hannahhhhhhhhhhhhhhh/custom-keyboard/images/pcb-3d.png

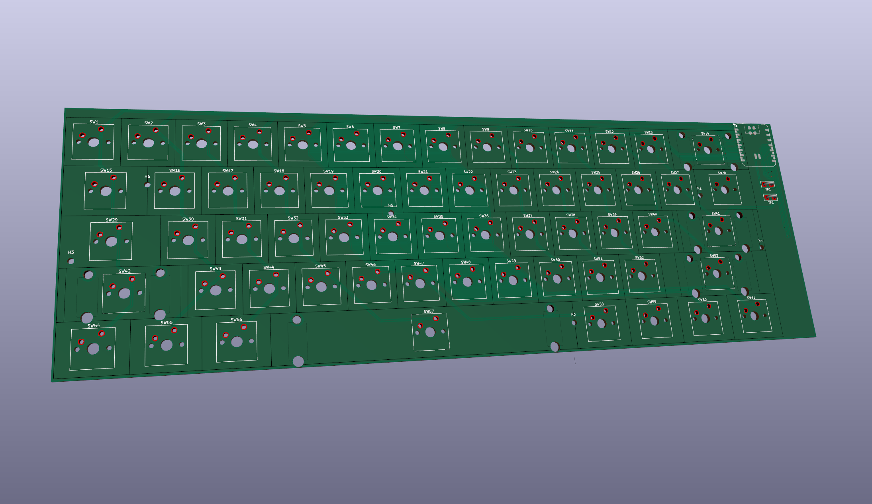
images/pcb-3d.png
