hannahhhhhhhhhhhhhhh/custom-keyboard/images/pcb.png

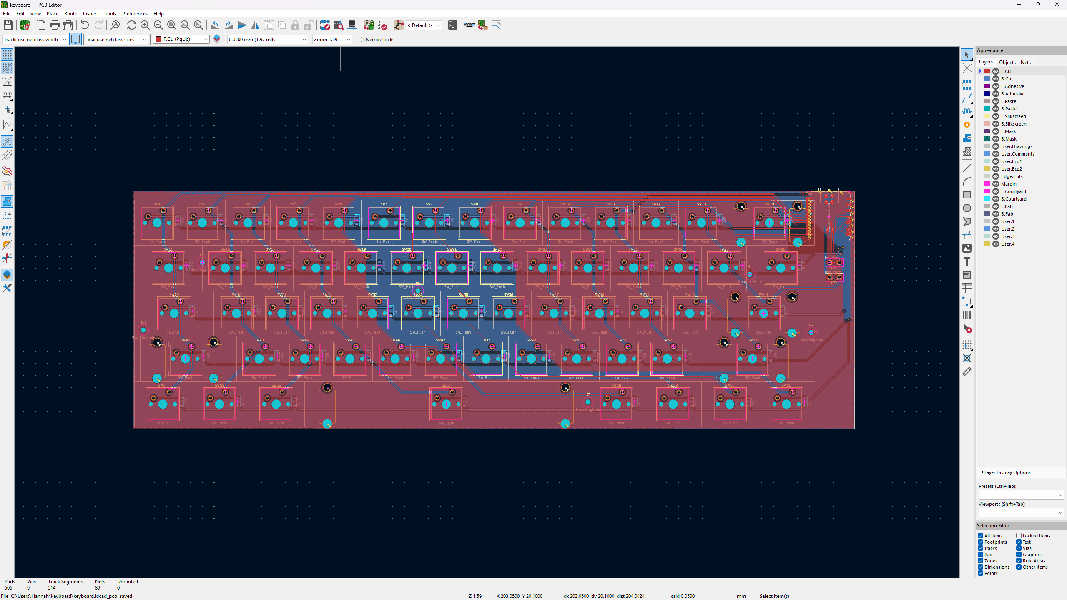
images/pcb.png
