hannahhhhhhhhhhhhhhh/custom-keyboard/images/schematic.png

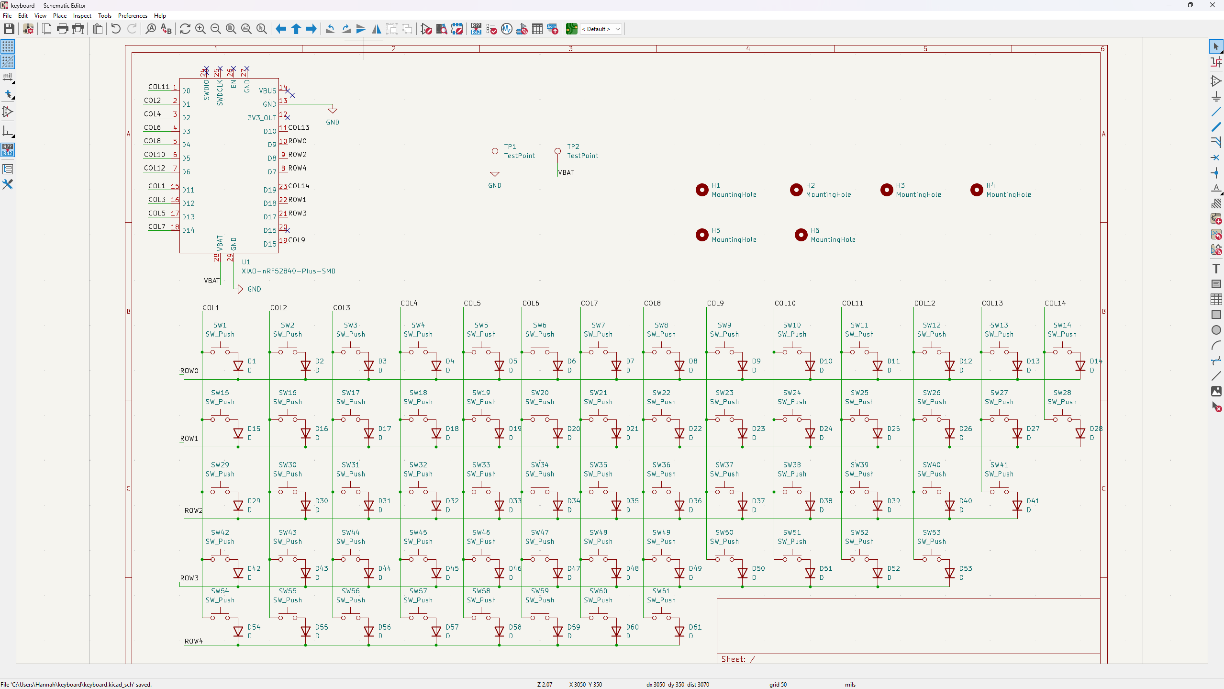
images/schematic.png
