hannahhhhhhhhhhhhhhh/custom-keyboard/BOM.csv

Item | Qty | Supplier | Cost/item | Total Cost | link
PCB | 1 | JLPCB | $34.12 | $34.12 | https://cart.jlcpcb.com/quote?stencilLayer=2&stencilWidth=100&stencilLength=100&stencilCounts=5&plateType=1
Seeed Studio XIAO nRF52840 Plus | 1 | Seeed studio | $15.00 | $15.00 | https://ca.robotshop.com/checkouts/cn/hWNHkaPCI6t1JQWKFscHSgSX/en-ca
ECSiNG 7Pcs 2U Stabilizers & 1Pcs 6.25U Stabilizer Replacement Mechanical Keyboard Stabilizers Plate Mount Stabilizers K | 1 | ECSiNG | $13.19 | $13.19 | https://www.amazon.ca/ECSiNG-Stabilizers-Stabilizer-Replacement-Accessories/dp/B0FGHP1QQN
Estimated total shipping | 1 |  |  | $40.47
