hannahhhhhhhhhhhhhhh/custom-keyboard/JOURNAL.md

# mechanical keyboard: devlog

<!-- Generated by Half Life from project b6safdi3w72jnbnciox2tt2c. Edits here are overwritten on the next sync. -->
<!-- Generated: 2026-11-07T22:35:55.124Z -->

> [!NOTE]
> This devlog is mirrored from [Half Life](https://halflife.hackclub.com) ([open the project](https://halflife.hackclub.com/projects/b6safdi3w72jnbnciox2tt2c)). Editing it here will not change the platform's copy, and the next sync overwrites this file.

> This week I've been sick at home but I get a lot of time each day to work on my project! I want to make my first mechanical keyboard :D I also learned rmk for the firmware of this project and learned about keyboard matrixes, downloaded a bunch of footprint libraries and it was fun. Initially I wanted to just make a standard 60% keyboard so I can buy a case, but ended up just making a custom one.  Sorry I couldn't add the STEP files to the 3D viewer to make it look better. my computer keeps crashing when I  go to the footprint editor trying to give it a model

| Week | Tier | Hours logged | Entries |
| --- | --- | --- | --- |
| Week 5 | Tier 3 | 28.5h | 12 |

## Contents

1. [2026-11-04: ](#2026-11-04-imagehttpshalflifehackclub-assetscomsessionsyitt1)
2. [2026-11-04:  em I just did the battery thing and realis](#2026-11-04-imagehttpshalflifehackclub-assetscomsessionsyitt1)
3. [2026-11-05: so! i forgor keys have different sizes. and that stabalizers are a thing. so time to add them:](#2026-11-05-so-i-forgor-keys-have-different-sizes-and-that-st)
4. [2026-11-05: alr added the battery thingy after removing it.](#2026-11-05-alr-added-the-battery-thingy-after-removing-it)
5. [2026-11-05: alr late night session:](#2026-11-05-alr-late-night-session)
6. [2026-11-06: oh boy.... firmware time](#2026-11-06-oh-boy-firmware-time)
7. [2026-11-06: honestly, these 3 hours went mostly in troubleshooting firmware, rewriting firmware, rewriting keyboard.toml,  rewriting keyboard.toml, rewriting keyboard.toml, and discovering that it was not my prob](#2026-11-06-honestly-these-3-hours-went-mostly-in-troubleshoo)
8. [2026-11-06: ](#2026-11-06-imagehttpshalflifehackclub-assetscomsessionsyitt1)
9. [2026-11-06: getting the parts prices. kinda expensive](#2026-11-06-imagehttpshalflifehackclub-assetscomsessionsyitt1)
10. [2026-11-06: ive been working on this like the whole day ![image](https://halflife.hackclub-assets.com/sessions/YITT1BpIhaUfu2wESuCR2Vtd1HPsflo7/75fb0d03e48f4bb6bfa1e31089601be968123c0c54cd4f1a398dd703231ae498.png](#2026-11-06-ive-been-working-on-this-like-the-whole-day-image)
11. [2026-11-07: doing some housekeeping tasks this session: fixed all the errors and stuff on kicad, pcb officially complete! AND THE FIRMWARE WORKS!!!!!!!!!!!!!!!!!!!!!](#2026-11-07-doing-some-housekeeping-tasks-this-session-fixed-)
12. [2026-11-07: IM DONE!!! YAYY!!!](#2026-11-07-im-done-yayy)

## Design

### 2026-11-04: 

**4h**


to start my project I did some research learning about details of full keyboards because even though I've done projects with keys.. this has more keys sooo I need more help

(aggressively learning about matrix and restarting my work like 5 times)

then i settled with this keyboard layout...
oops just realized wrong microcontroller: there we go


YIPPEE



### 2026-11-04:  em I just did the battery thing and realis

**1h**

 em I just did the battery thing and realised I have no pins left oops. Also assigned all the footprints and spent a while on figuring out why I can't find a footprint for my microcontroller but eventually figured it out



### 2026-11-05: so! i forgor keys have different sizes. and that stabalizers are a thing. so time to add them:

**4h**

so! i forgor keys have different sizes. and that stabalizers are a thing. so time to add them:

 thats better

 i placed the pcb using the keyboad builder exported json because i wanted to make it fit in an typical 60% aluminum case and not a printed one

 um. also forgot microcontrollers exist and it doesnt fit. I'll need a custom case anyways. there goes 1 hour of rearranging everything

 also slight restart of the schematic bc i wired it wrong first time and i wanted it to be neater

### 2026-11-05: alr added the battery thingy after removing it.

**2h**

alr added the battery thingy after removing it.


..........so 30 minutes later im proud to announce: I REMOVED IT AGAIN YAYAYYAYAY!!!!

 :sobbing:
aaand time to change the firmware thingy too then rewire pcb again

### 2026-11-05: alr late night session:

**1h**

alr late night session:

 fixing stabilizer thingy i have no clue how it works so went through a ton of googling.

 idk apparently it was kicad thing and i can ignore all the stabilizer overlap errors so i just ignored it

### 2026-11-06: oh boy.... firmware time

**4h**

oh boy.... firmware time
so, hour one went to learning rmk from scratch :fear:


and I chose cloud compilation.
yes, that went another one hour.


it was then I realised, I may have to reread the entire guide and then it's time to edit the toml thingy.

and I found another guide telling me how to do the json file because ive been using arduino as my firmware for toher projects. this is lowkey taking so much more time than the actual pcb.



### 2026-11-06: honestly, these 3 hours went mostly in troubleshooting firmware, rewriting firmware, rewriting keyboard.toml,  rewriting keyboard.toml, rewriting keyboard.toml, and discovering that it was not my prob

**3h**

honestly, these 3 hours went mostly in troubleshooting firmware, rewriting firmware, rewriting keyboard.toml,  rewriting keyboard.toml, rewriting keyboard.toml, and discovering that it was not my problem. local compilation time!!! theres a TON of downloading and my wifi was not helping.
lowkey spent 30+ minutes downloading everything
and i had some trouble with windows defender not allowing me to download anything cuz its a new device and didn't set everything up yet.

 genuinely praying to my computer as the things ran

 i mean i dont really have a lot of photos other than my cmd window but,

heres the things i downloaded : rust, clang, c++ thing, visual studio, then all the tools

### 2026-11-06: 

**2h**


so basically I accidentally deleted this draft when clicking preview ;-;
tdlr, noticed something wrong with schematic, redid schematic, redid pcb, edited keyboard.toml and doing more firmware stuffs.
almost done though! righht


### 2026-11-06: getting the parts prices. kinda expensive

**2h**

getting the parts prices. kinda expensive
im choosing to make jlpcb solder the diodes for me because somehow every diode cost like $25 shipping...ive been searching around for rlly long and the individual parts shipping are too expensive so im getting all from jlcpcb

 dont question why ordering took so long lol when doing the bom i realised I had to fix some footprints

### 2026-11-06: ive been working on this like the whole day ![image](https://halflife.hackclub-assets.com/sessions/YITT1BpIhaUfu2wESuCR2Vtd1HPsflo7/75fb0d03e48f4bb6bfa1e31089601be968123c0c54cd4f1a398dd703231ae498.png

**1.5h**

ive been working on this like the whole day  mfw shipping
an hour of this session went to trying to find the cheapest parts. i mean ahem cheapest shipping. sooo 45 dollars of my hundred dollar budget is going to shipping lol nothing i can do about that
on the bright side, progress for firmware!!!!realised i mapped the layout wrong so hopefully now its fixed
 my parents are screaming at me to go to sleep I'll continue it tomorrow

 o/

### 2026-11-07: doing some housekeeping tasks this session: fixed all the errors and stuff on kicad, pcb officially complete! AND THE FIRMWARE WORKS!!!!!!!!!!!!!!!!!!!!!

**3h**

doing some housekeeping tasks this session: fixed all the errors and stuff on kicad, pcb officially complete! AND THE FIRMWARE WORKS!!!!!!!!!!!!!!!!!!!!!
github time. since i did it on two devices it took a bit to transfer the files around and stuff. then I wrote my amazing readme



 I love kicad <3
this thing should be done really soon now, just gotta get the 3d models for the keys so readme is less ugly





### 2026-11-07: IM DONE!!! YAYY!!!

**1h**

IM DONE!!! YAYY!!!
so, github is complete, bom is complete, the location csv thingy is done and correct, found all the parts needed, checked the firmware against the seeed studio website one more time and made sure everything is actually correct
did some better screenshots of my finished work




now, sadly, I can touch grass
